id140123/ENV-AQ-01/Test BME680/bme680.jpg

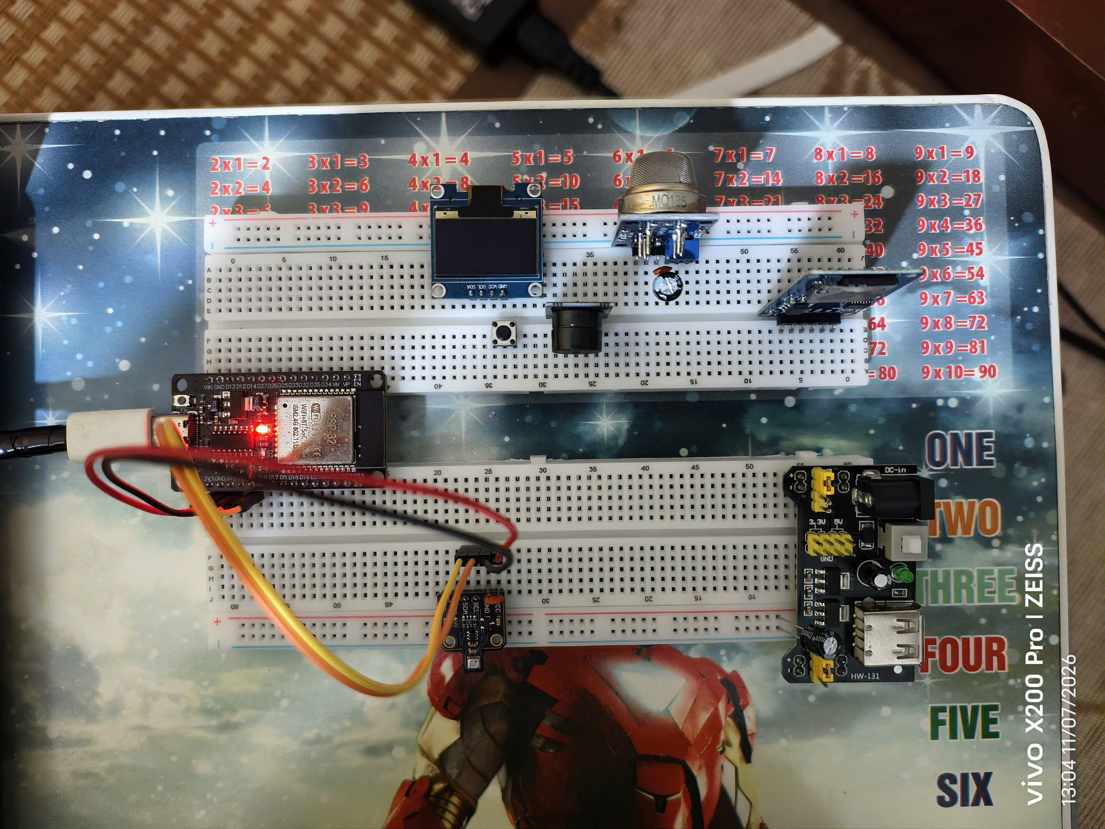
Test BME680/bme680.jpg
