id140123/ENV-AQ-01/Test APM2000/apm2000.jpg

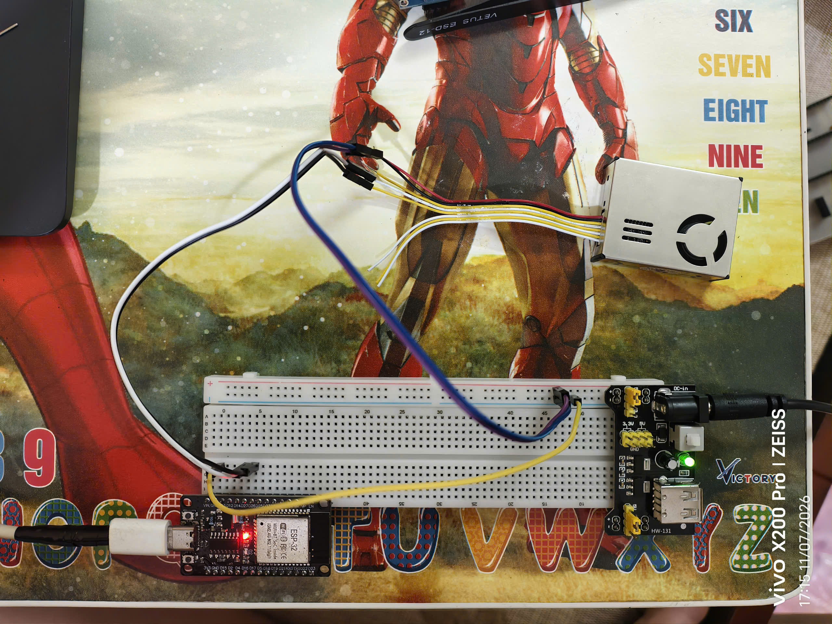
Test APM2000/apm2000.jpg
