id140123/ENV-AQ-01/README.md

# ENV-AQ-01
Trạm Quan Trắc Chất Lượng Không Khí Đa Thông Số
