id140123/ENV-AQ-01/Tài liệu liên quan/Blynk_pinout.png

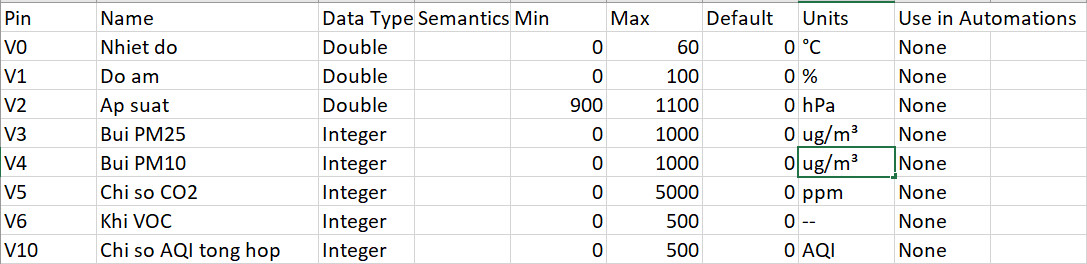
Tài liệu liên quan/Blynk_pinout.png
