id140123/ENV-AQ-01/Tài liệu liên quan/Đề tài.png

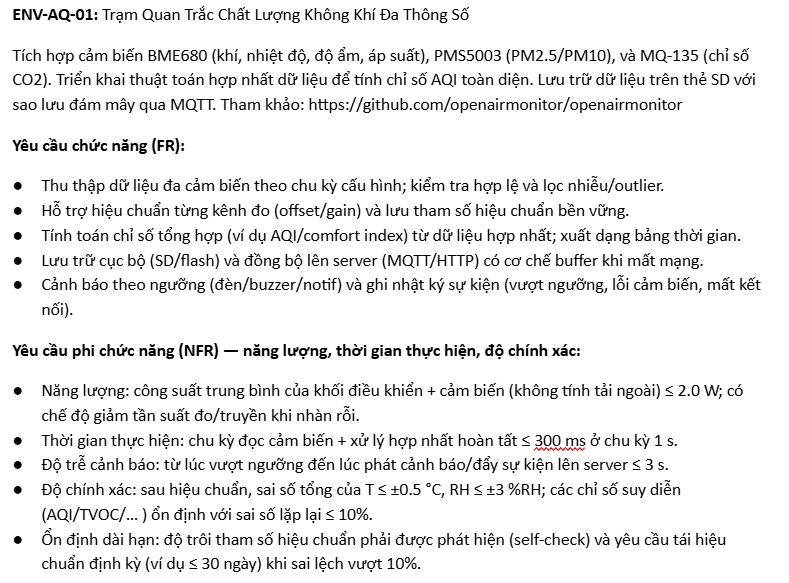
Tài liệu liên quan/Đề tài.png
