id140123/ENV-AQ-01/Tổng thể dự án/1.jpg

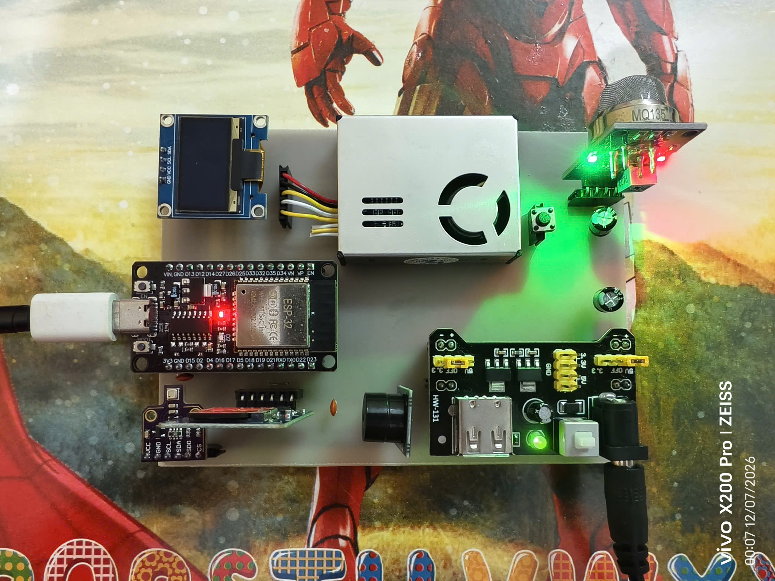
Tổng thể dự án/1.jpg
