id140123/ENV-AQ-01/Tổng thể dự án/2.jpg

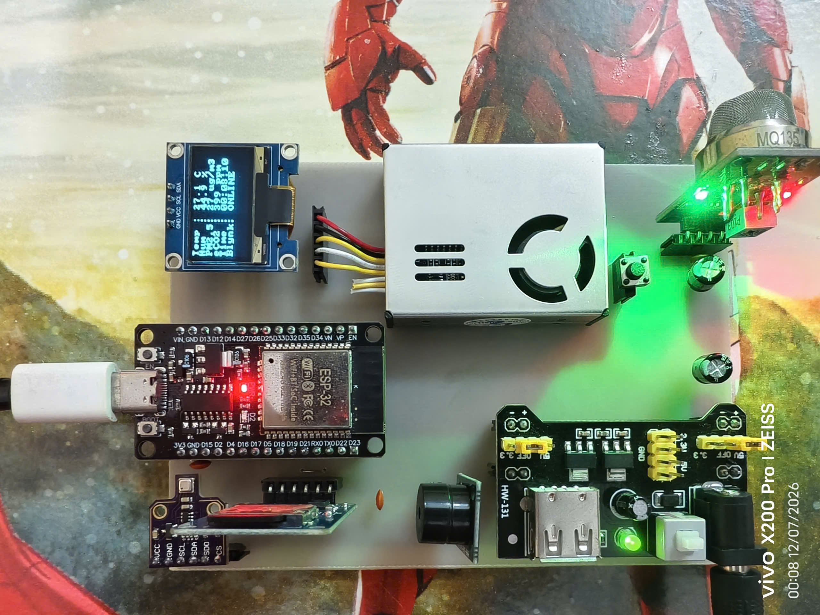
Tổng thể dự án/2.jpg
