id140123/ENV-AQ-01/Tổng thể dự án/3.png

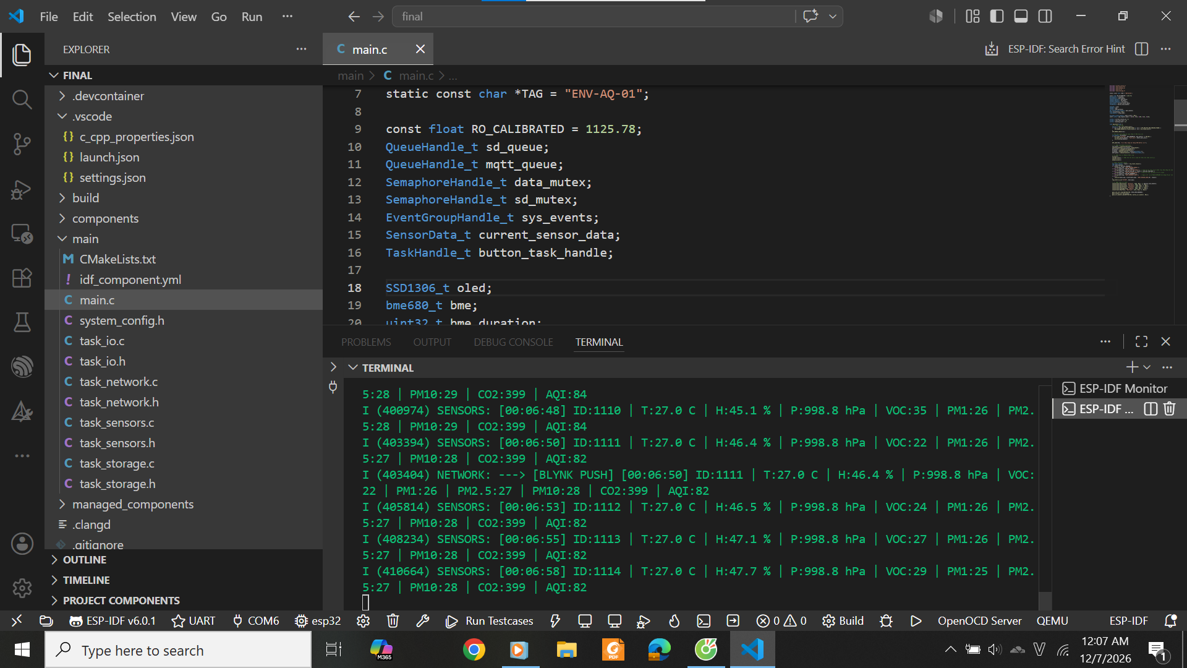
Tổng thể dự án/3.png
