id140123/ENV-AQ-01/Tổng thể dự án/4.png

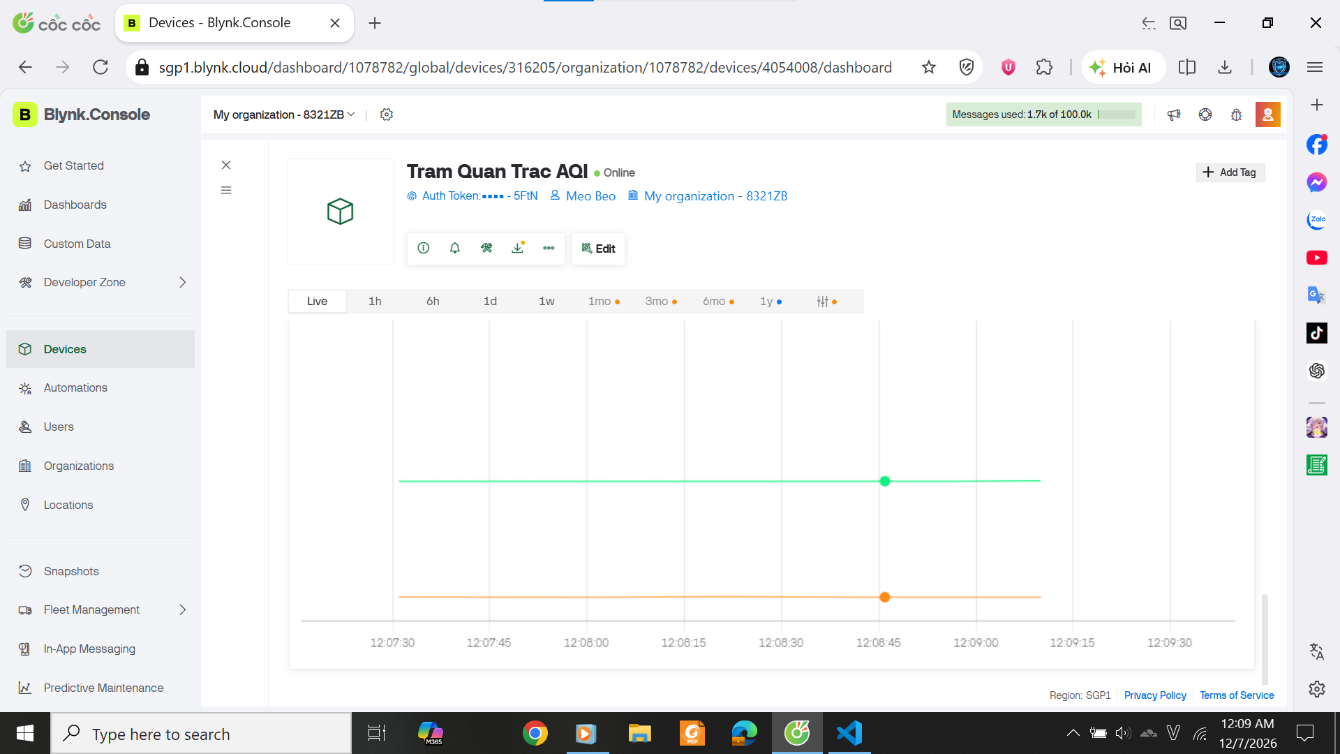
Tổng thể dự án/4.png
