id140123/ENV-AQ-01/Test APM2000/test_apm2000.png

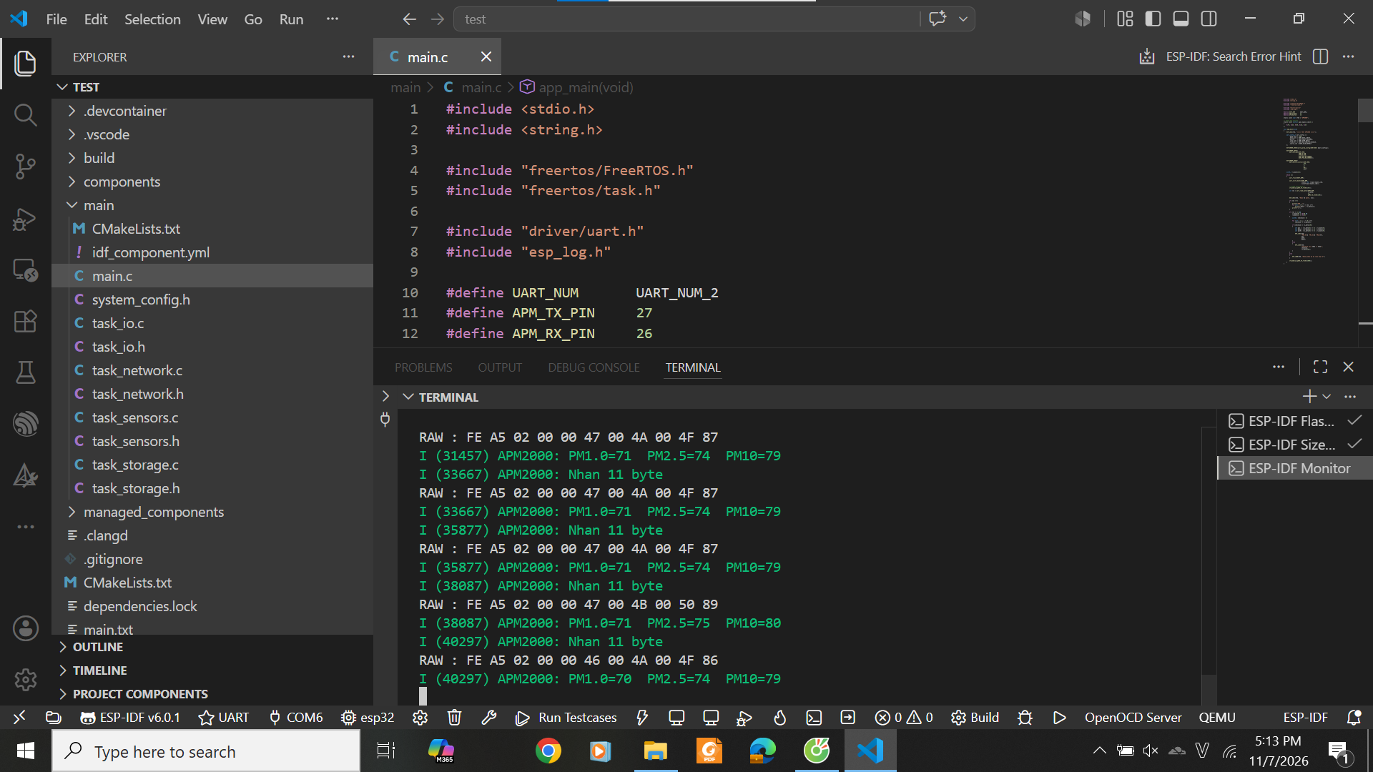
Test APM2000/test_apm2000.png
