id140123/ENV-AQ-01/Test Module thẻ SD/module_the_sd.jpg

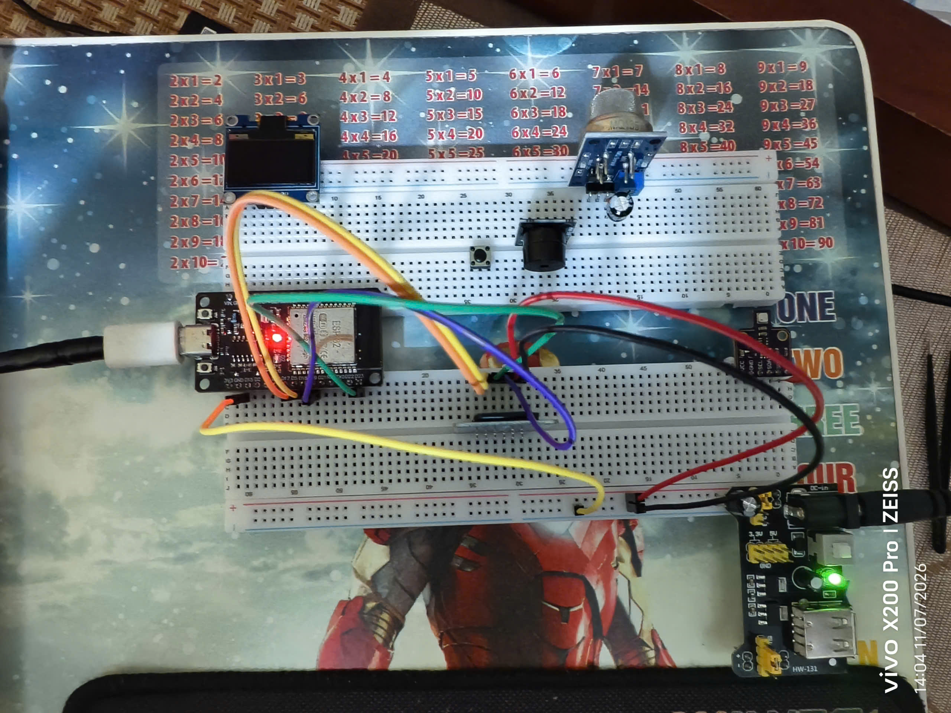
Test Module thẻ SD/module_the_sd.jpg
