id140123/ENV-AQ-01/Test Module thẻ SD/test_module_the_sd.png

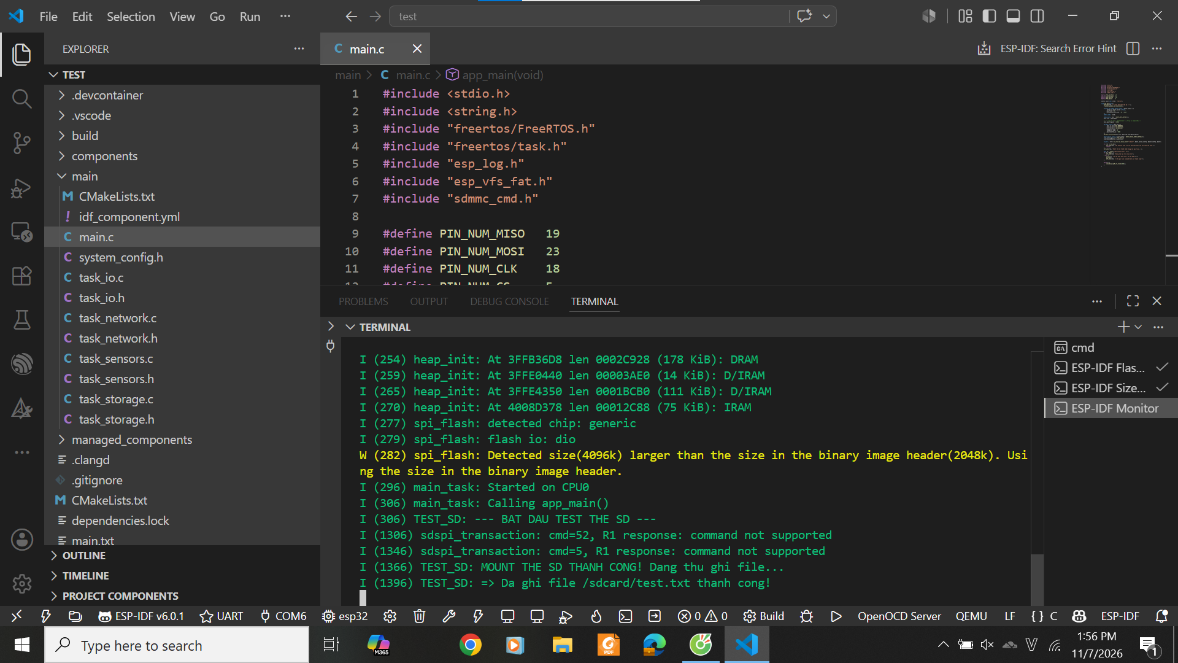
Test Module thẻ SD/test_module_the_sd.png
