id140123/ENV-AQ-01/Test MQ135/mq135.jpg

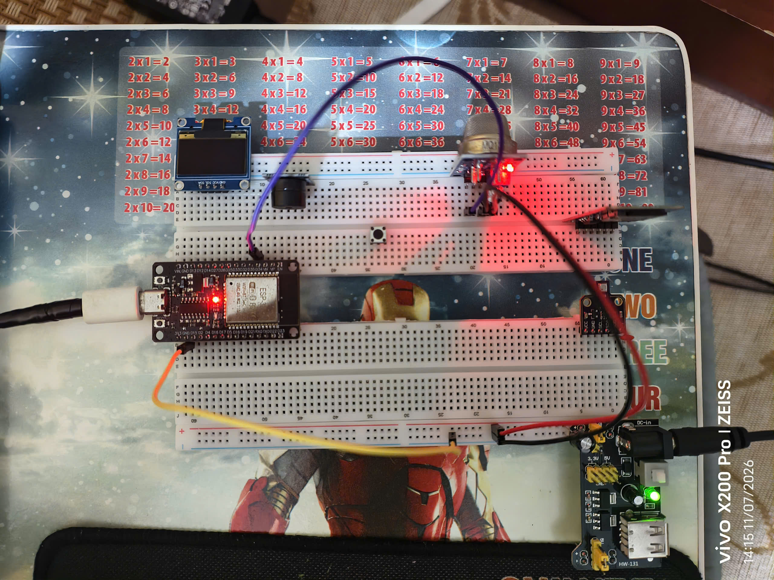
Test MQ135/mq135.jpg
