id140123/ENV-AQ-01/Test MQ135/test_mq135.png

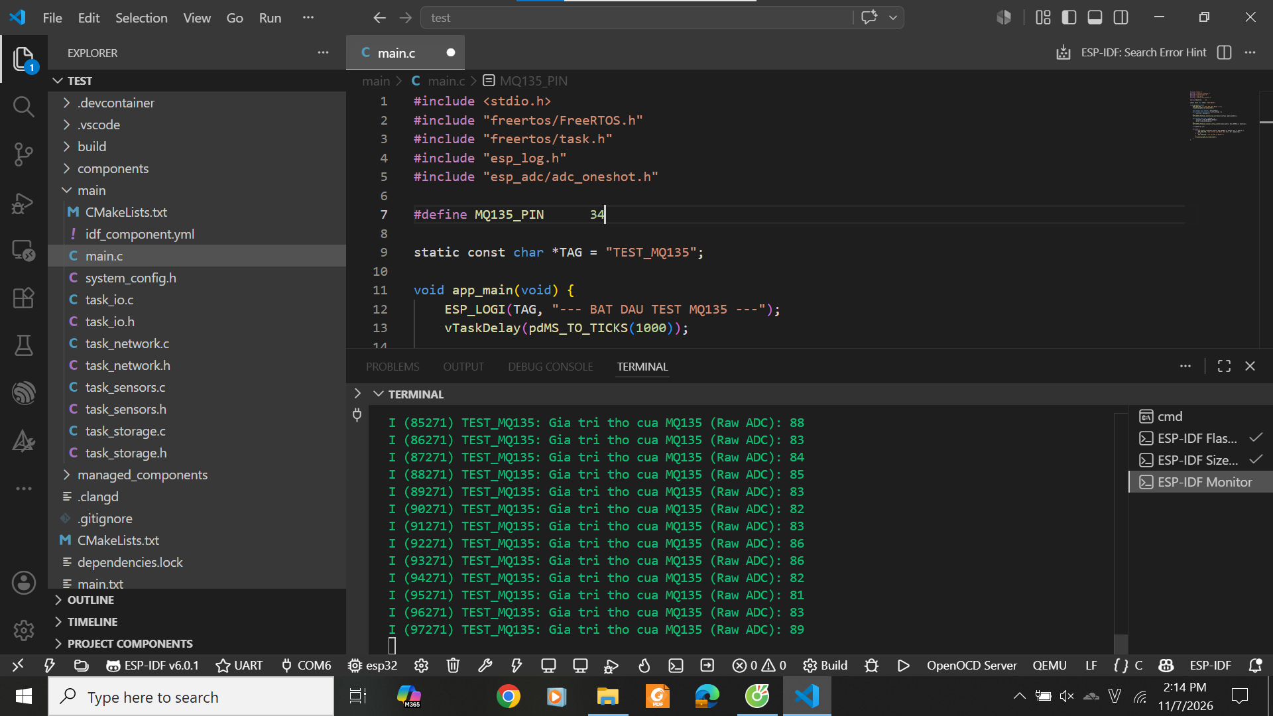
Test MQ135/test_mq135.png
