id140123/ENV-AQ-01/Test Oled/oled.jpg

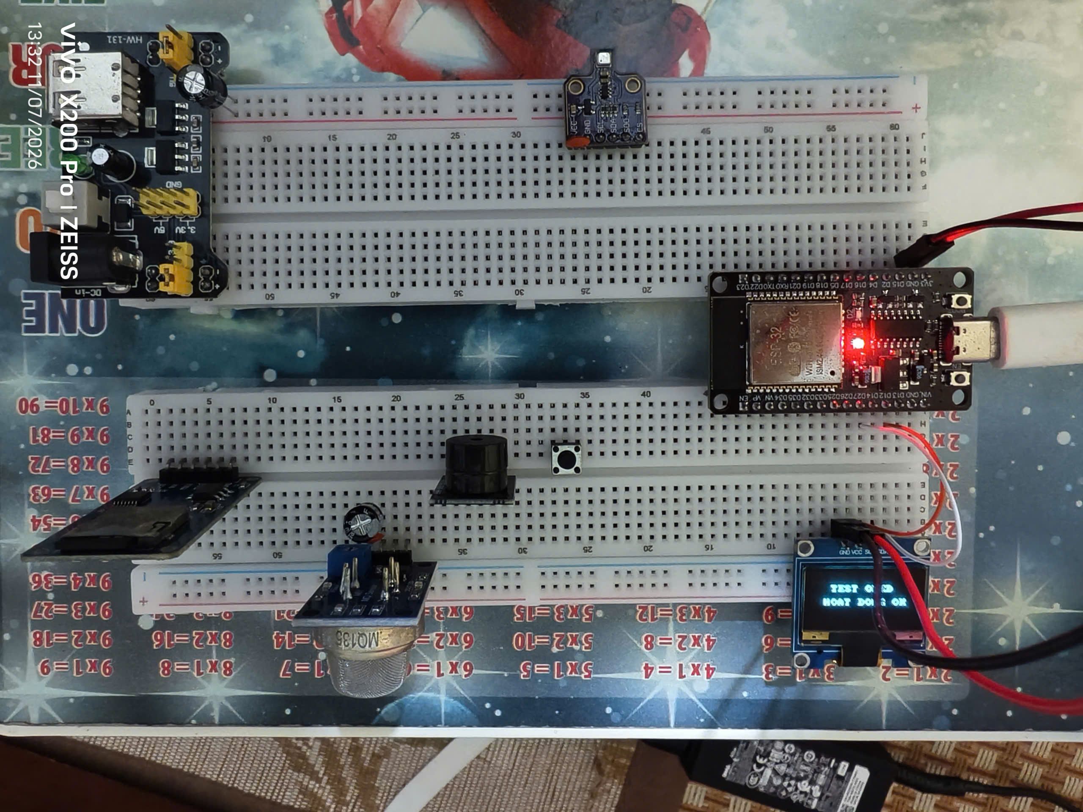
Test Oled/oled.jpg
