id140123/ENV-AQ-01/Test Oled/test_oled.png

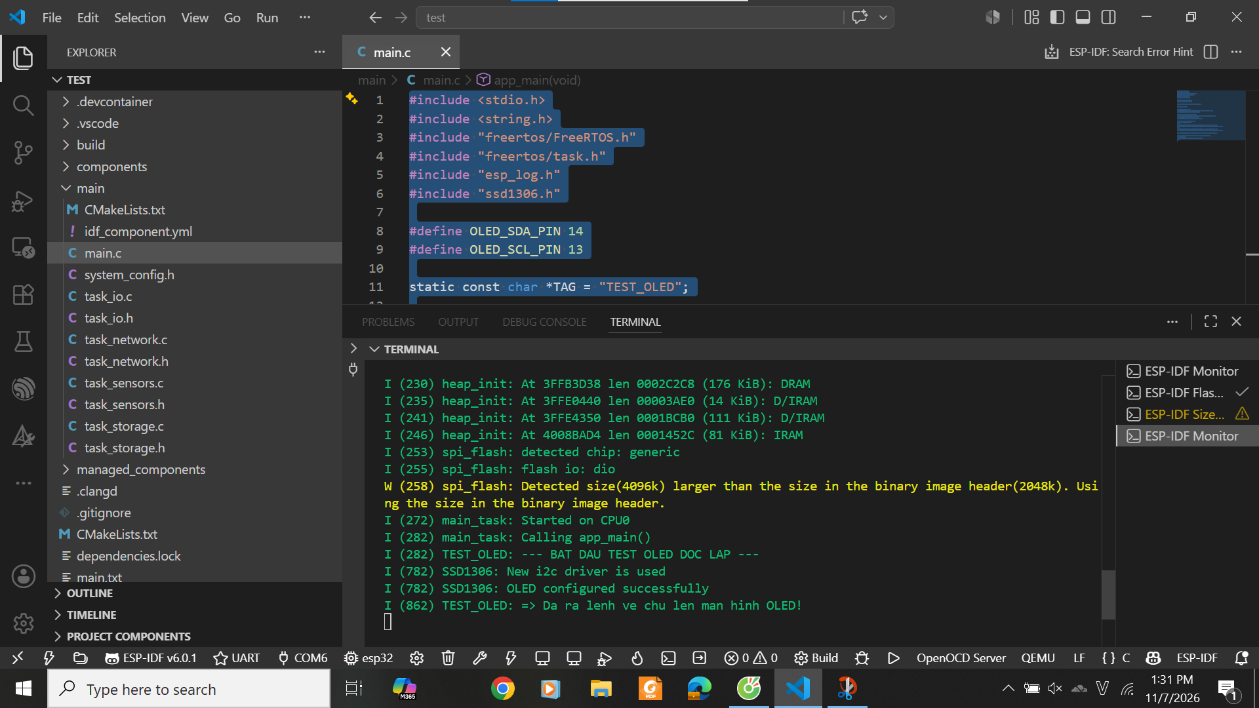
Test Oled/test_oled.png
