id140123/ENV-AQ-01/(list of files, drawings)

Other design files:
Final PCB.PcbDoc
